b-vineeth/Drone-Assembly/(list of files, cad)

Other CAD files:
Autodesk Inventor Files/Drone Exploded Assembly.dwg
Autodesk Inventor Files/Drone Assembly.dwg
Autodesk Inventor Files/Motor Arm and Propeller.dwg
Autodesk Inventor Files/ANSI B18.3 - 6-32 UNC - 0.4375(31).ipt
Autodesk Inventor Files/ANSI B18.3 - 6-32 UNC - 0.5(30).ipt
Autodesk Inventor Files/ArmAssembly.iam
Autodesk Inventor Files/ArmAssembly.ipn
Autodesk Inventor Files/Battery Pack.ipt
Autodesk Inventor Files/Cable & Harness/en-US/harness.iam
Autodesk Inventor Files/Compress Spring11.ipt
Autodesk Inventor Files/Drone Assembly.iam
Autodesk Inventor Files/Drone Assembly.ipn
Autodesk Inventor Files/Electronics.ipt
Autodesk Inventor Files/Motor Full Arm.ipt
Autodesk Inventor Files/Motor.ipt
Autodesk Inventor Files/Pin GB 878-86 6 x 20.ipt
Autodesk Inventor Files/PropellerAssembly.iam
Autodesk Inventor Files/Tube & Pipe/en-US/piping runs.iam
Autodesk Inventor Files/bottom_plate.ipt
Autodesk Inventor Files/charging_port.ipt
Autodesk Inventor Files/l_bracket.ipt
Autodesk Inventor Files/motor_shaft.ipt
Autodesk Inventor Files/prop_base (1).ipt
Autodesk Inventor Files/prop_blade.ipt
Autodesk Inventor Files/prop_retaining_part.ipt
Autodesk Inventor Files/slider.ipt
Autodesk Inventor Files/top_plate.ipt
