b-vineeth/Drone-Assembly/Deliverables/Exploded assembly view-Drone.pdf

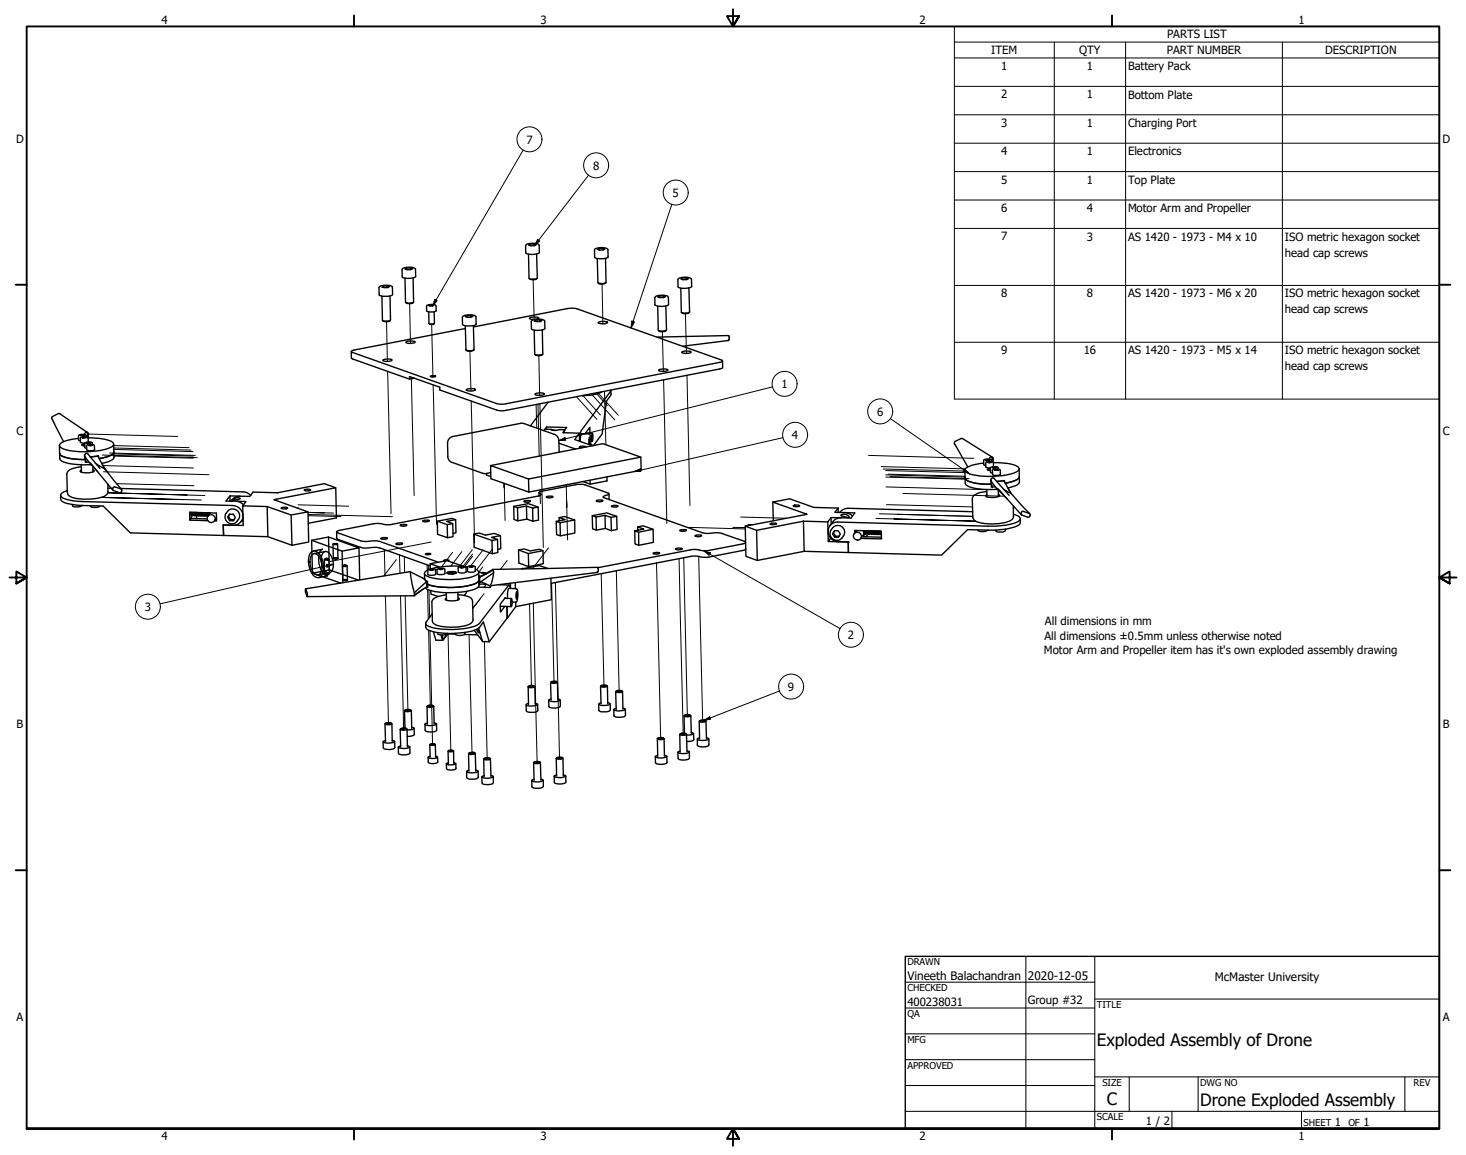
[picture p22: page 1]

PARTS LIST

ITEM | QTY | PART NUMBER | DESCRIPTION
1 | 1 | Battery Pack

2 | 1 | Bottom Plate

3 | 1 | Charging Port

4 | 1 | Electronics

5 | 1 | Top Plate

6 | 4 | Motor Arm and Propeller

7 | 3 | AS 1420 - 1973 - M4 x 10 | ISO metric hexagon socket head cap screws

8 | 8 | AS 1420 - 1973 - M6 x 20 | ISO metric hexagon socket head cap screws

9 | 16 | AS 1420 - 1973 - M5 x 14 | ISO metric hexagon socket head cap screws

All dimensions in mm
All dimensions ±0.5mm unless otherwise noted
Motor Arm and Propeller item has it's own exploded assembly drawing

DRAWN Vineeth Balachandran | 2020-12-05 | McMaster University

CHECKED 400238031 | Group #32

MFG

Exploded Assembly of Drone

APPROVED

SIZE C | DWG NO Drone Exploded Assembly | REV

SCALE 1 / 2 | | SHEET 1 OF 1
