b-vineeth/Drone-Assembly/Deliverables/bottom plate multiview.pdf

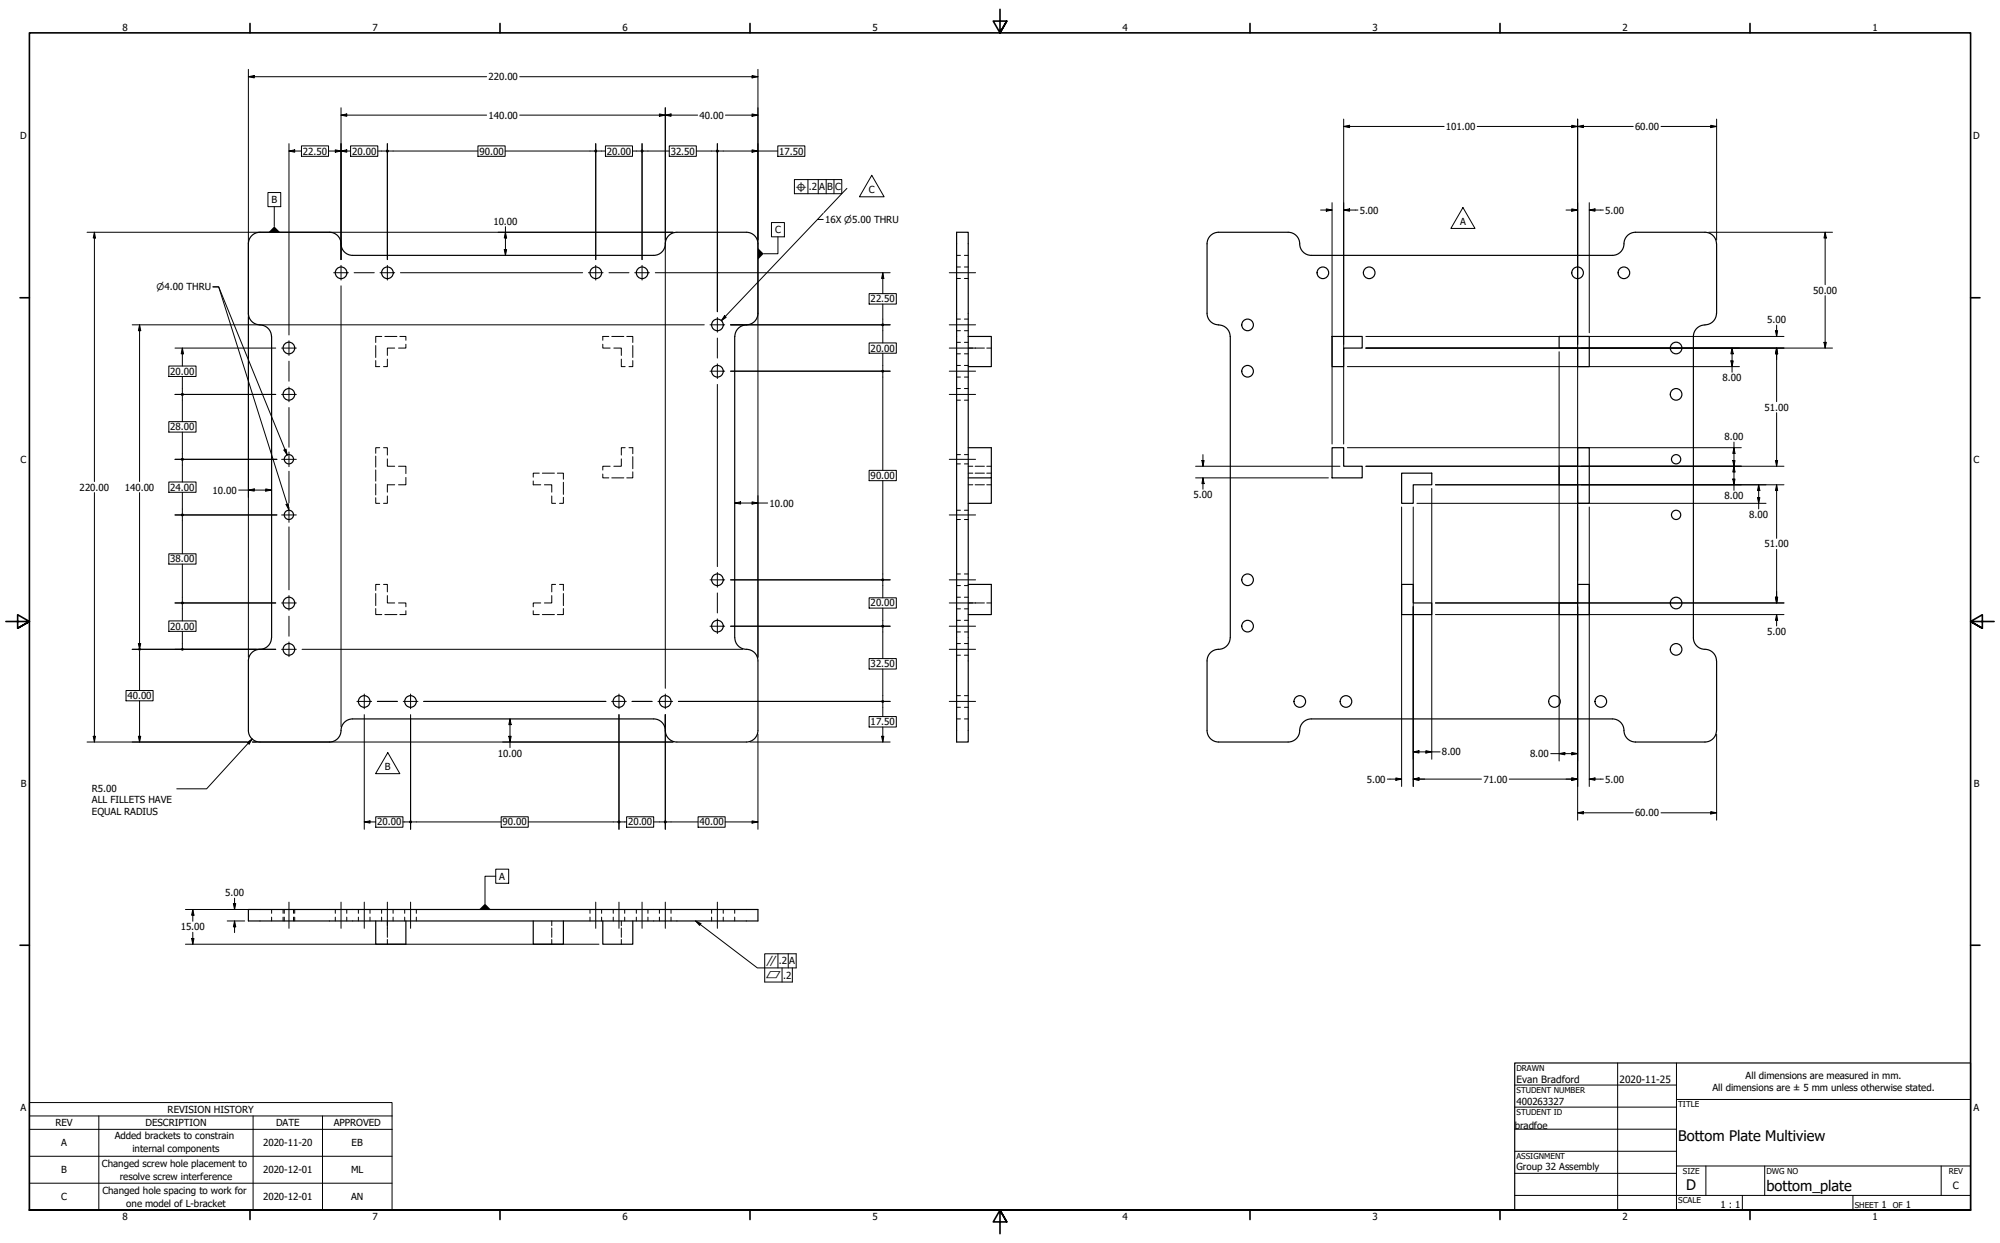
[picture p24: page 1]
Group 32 Assembly; REVISION HISTORY

ALL FILLETS HAVE
EQUAL RADIUS

 .2 A
.2

DRAWN Evan Bradford | 2020-11-25 | All dimensions are measured in mm. All dimensions are ± 5 mm unless otherwise stated.

STUDENT NUMBER 400263327

STUDENT ID bradfoe

REV | DESCRIPTION | DATE | APPROVED
A | Added brackets to constrain internal components | 2020-11-20 | EB

Bottom Plate Multiview

B | Changed screw hole placement to resolve screw interference | 2020-12-01 | ML

SIZE D | DWG NO bottom_plate | REV C

C | Changed hole spacing to work for one model of L-bracket | 2020-12-01 | AN

SCALE 1 : 1 | | SHEET 1 OF 1
