b-vineeth/Drone-Assembly/Deliverables/L bracket multiview.pdf

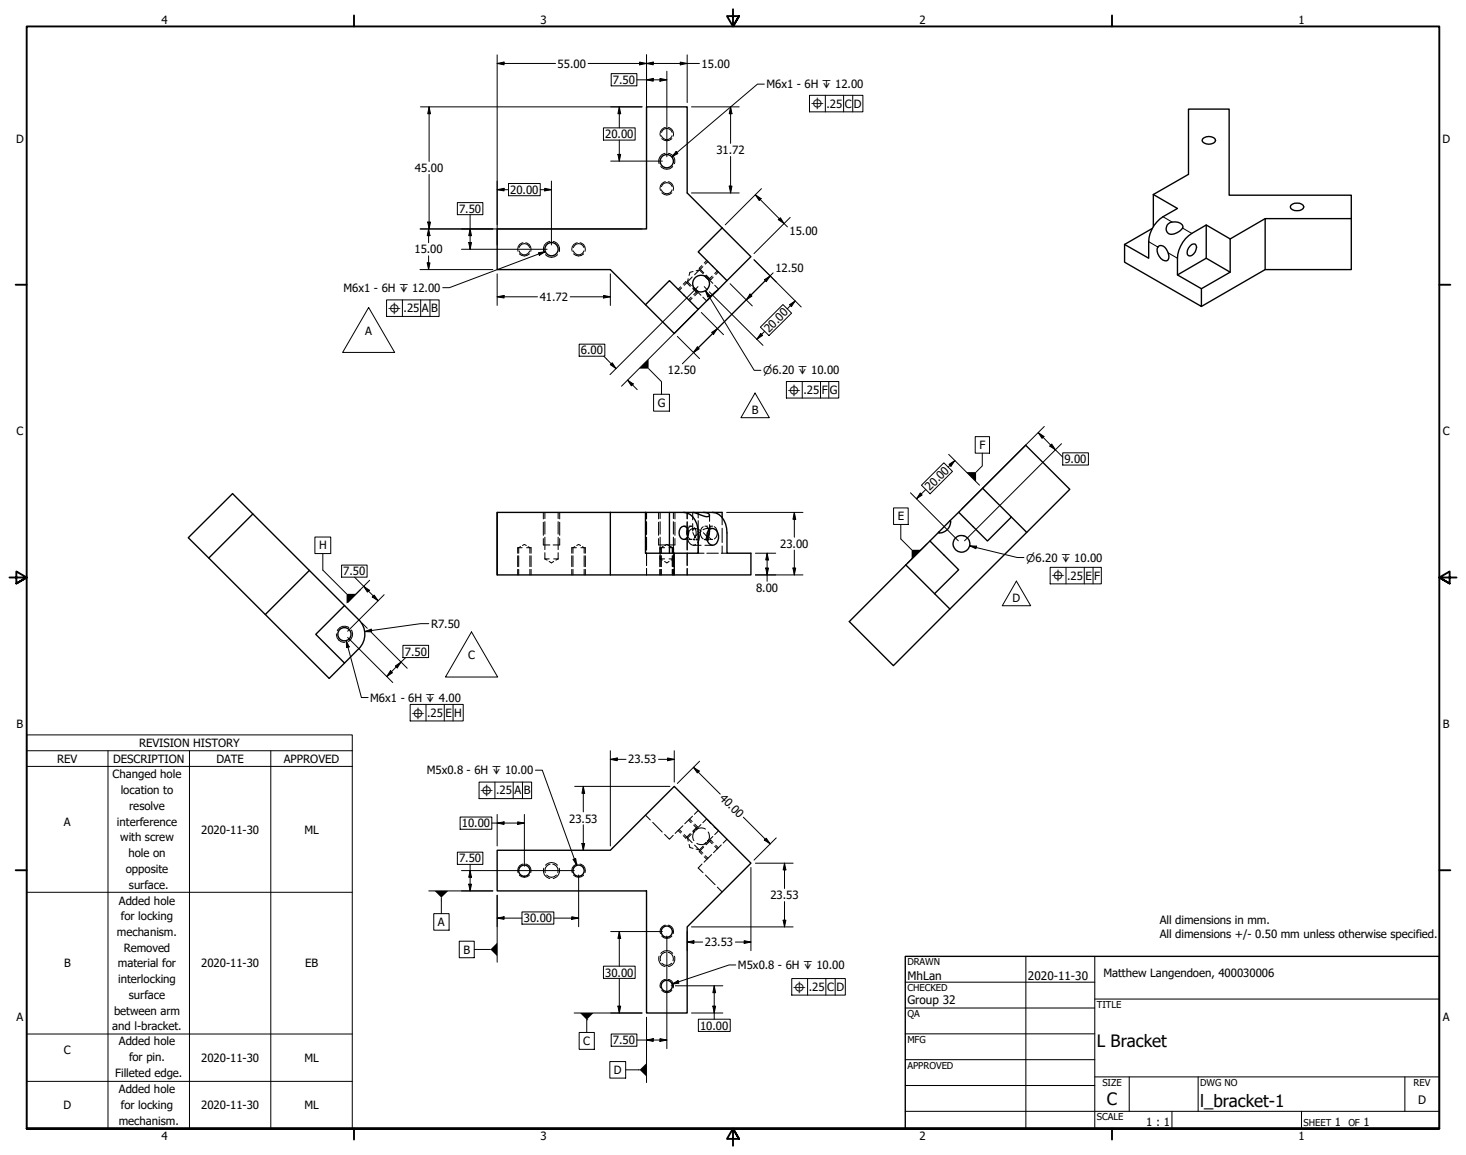
[picture p25: page 1]
L Bracket; REVISION HISTORY; Added hole for pin. Filleted edge.

REV | DESCRIPTION | DATE | APPROVED
A | Changed hole location to resolve interference with screw hole on opposite surface. | 2020-11-30 | ML

B | Added hole for locking mechanism. Removed material for interlocking surface between arm and l-bracket. | 2020-11-30 | EB

All dimensions in mm.
All dimensions +/- 0.50 mm unless otherwise specified.

DRAWN MhLan | 2020-11-30 | Matthew Langendoen, 400030006

CHECKED Group 32

SIZE C | DWG NO l_bracket-1 | REV D

D | Added hole for locking mechanism. | 2020-11-30 | ML

SCALE 1 : 1 | | SHEET 1 OF 1
