b-vineeth/Drone-Assembly/Deliverables/slider multiview.pdf

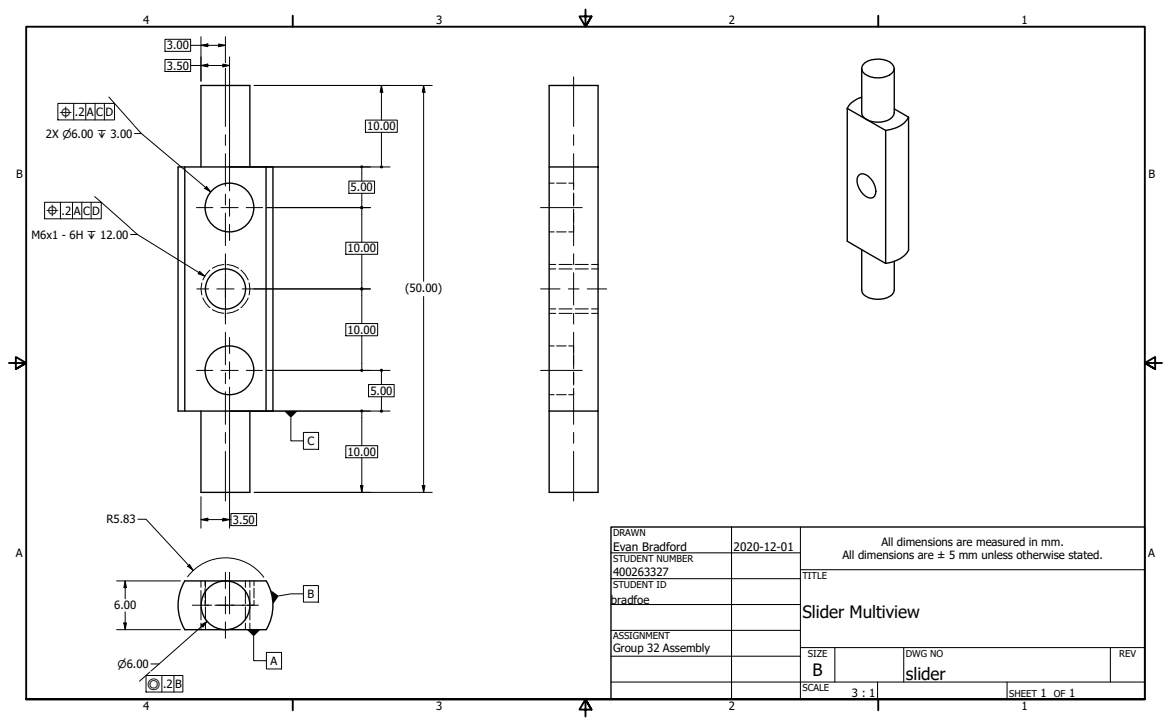
[picture p26: page 1]
Group 32 Assembly; Slider Multiview

DRAWN Evan Bradford | 2020-12-01 | All dimensions are measured in mm. All dimensions are ± 5 mm unless otherwise stated.

STUDENT NUMBER 400263327

STUDENT ID bradfoe

SIZE B | DWG NO slider | REV

SCALE 3 : 1 | | SHEET 1 OF 1
