b-vineeth/Drone-Assembly/Deliverables/top plate multiview.pdf

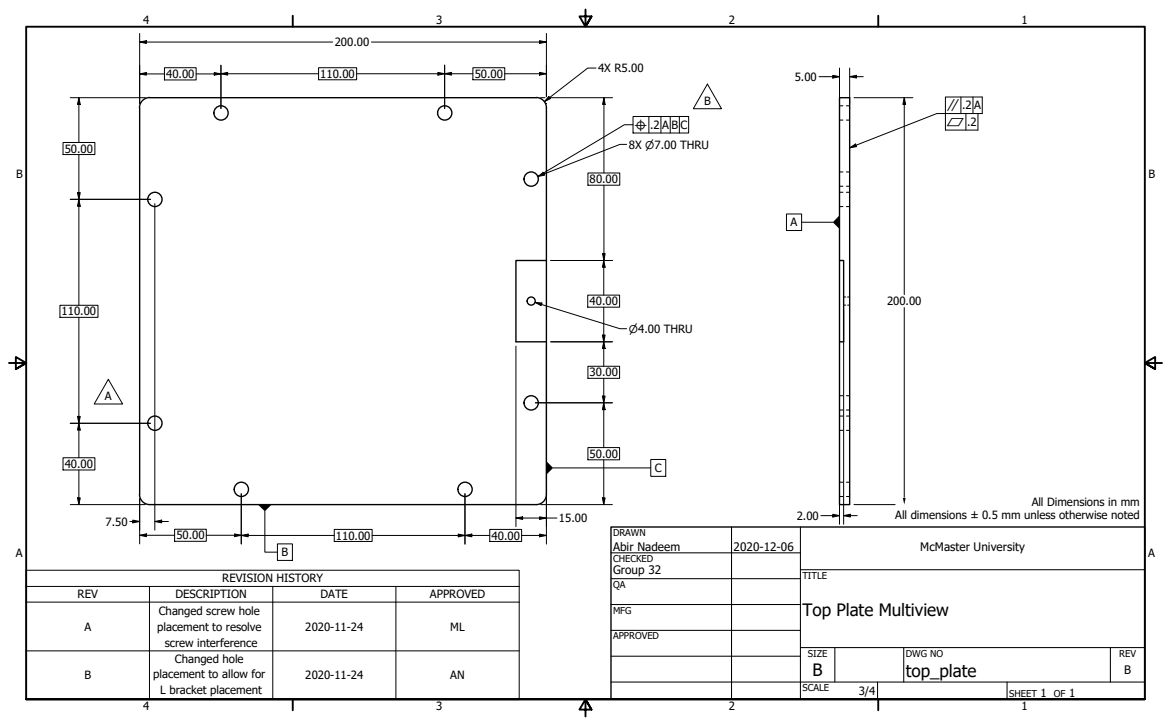
[picture p27: page 1]
REVISION HISTORY

.2 A
.2

All Dimensions in mm

All dimensions ± 0.5 mm unless otherwise noted

DRAWN Abir Nadeem | 2020-12-06 | McMaster University

CHECKED Group 32

REV | DESCRIPTION | DATE | APPROVED

Changed screw hole
placement to resolve
screw interference

Top Plate Multiview

SIZE B | DWG NO top_plate | REV B

B | Changed hole placement to allow for L bracket placement | 2020-11-24 | AN

SCALE 3/4 | | SHEET 1 OF 1
