b-vineeth/Drone-Assembly/Deliverables/Exploded assembly view-Arm.pdf

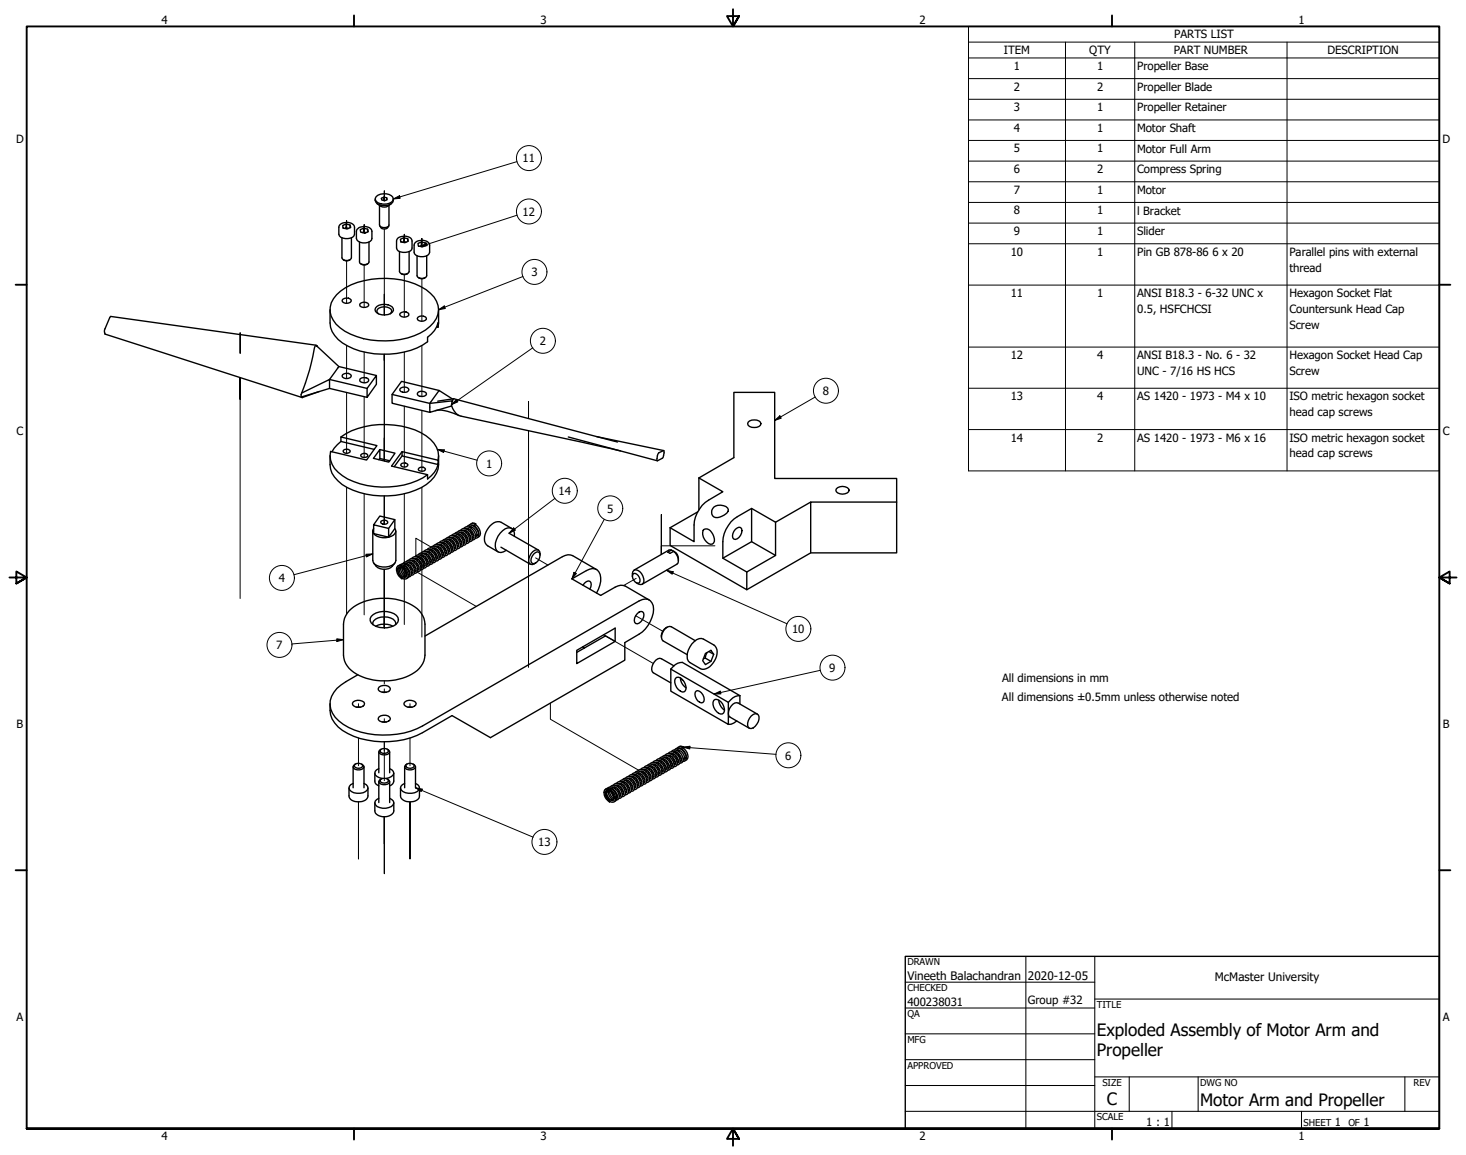
[picture p28: page 1]
All d

I T E M | Q TY | P A RT N U M B E R | D E S C R I P T I O N
1 | 1 | P r o p elle r B a s e
2 | 2 | P r o p elle r Bla d e
3 | 1 | P r o p elle r R e t a i n e r
4 | 1 | M o t o r S h a ft
5 | 1 | M o t o r F ull A r m
6 | 2 | C o m p r e s s S p r i n g
7 | 1 | M o t o r
8 | 1 | l B r a c k e t
9 | 1 | Sli d e r
1 0 1 1 | 1 1 | P i n G B 8 7 8 -8 6 6 x 2 0 A N S I B 1 8 . 3 -6 -3 2 U N C x 0 . 5 , H S F C H C S I | P a r allel p i n s w i t h e x t e r n al thread H e x a g o n S o c k e t Fla t C o u n t e r s u n k H e a d C a p S c r e w

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

S I Z E C | D W G N O M o t o r A r m a n d P r o p elle r | R E V
